Mr-Gollum/Identification-of-Dynamic-Properties-of-Thermocouples/Photos & videos/Construction complete.png

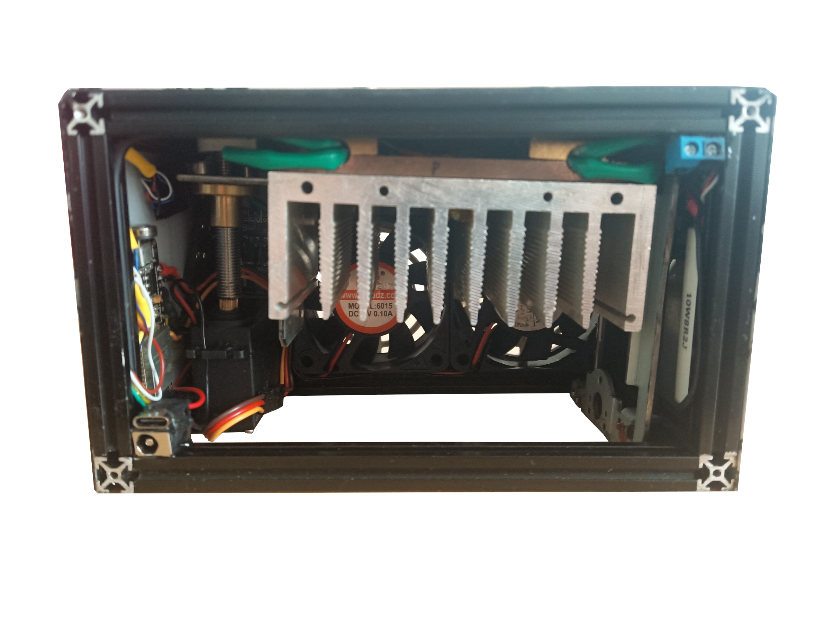
Photos & videos/Construction complete.png
