Mr-Gollum/Identification-of-Dynamic-Properties-of-Thermocouples/Photos & videos/Aluminum cooler linear slider.png

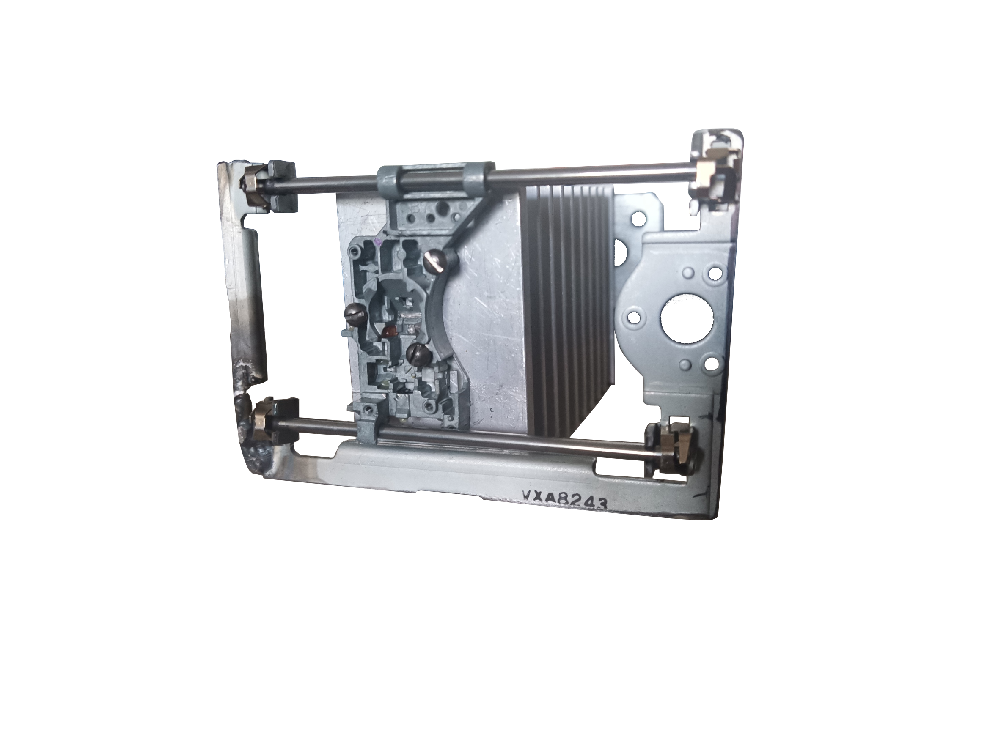
Photos & videos/Aluminum cooler linear slider.png
