Mr-Gollum/Identification-of-Dynamic-Properties-of-Thermocouples/Photos & videos/Copper cooler with additional blocks.png

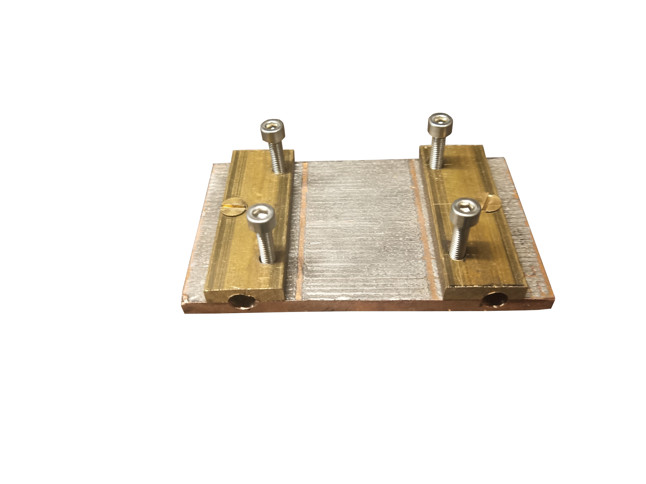
Photos & videos/Copper cooler with additional blocks.png
