Mr-Gollum/Identification-of-Dynamic-Properties-of-Thermocouples/Photos & videos/Copper cooler with DS18B20.png

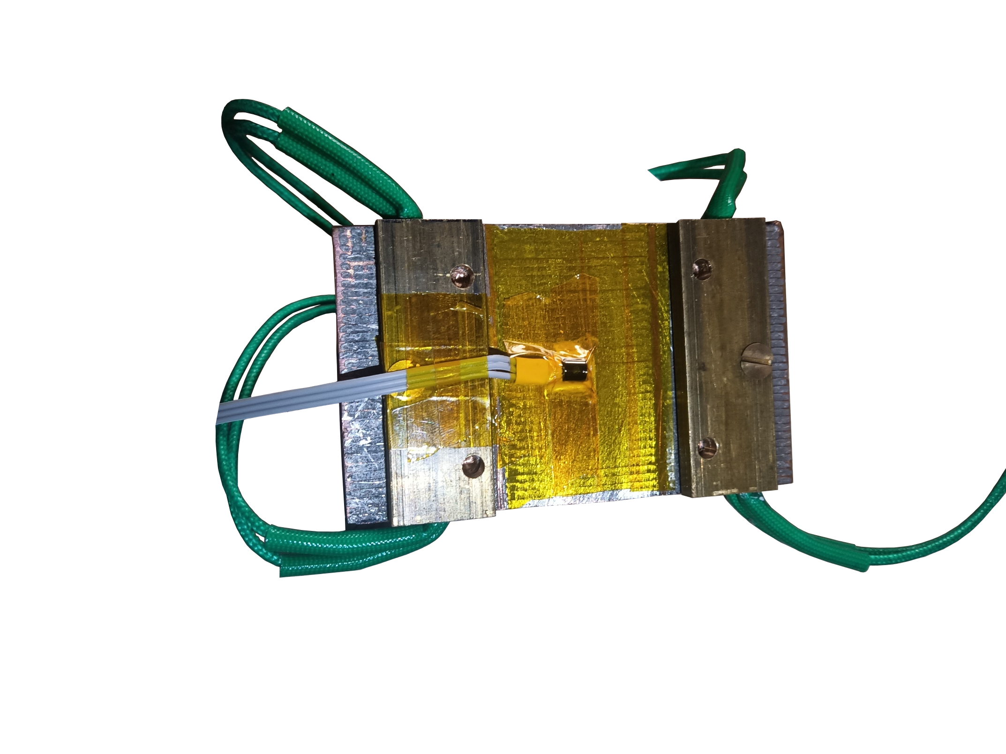
Photos & videos/Copper cooler with DS18B20.png
