Mr-Gollum/Identification-of-Dynamic-Properties-of-Thermocouples/Photos & videos/Frame with fans, heated block and mosfets.png

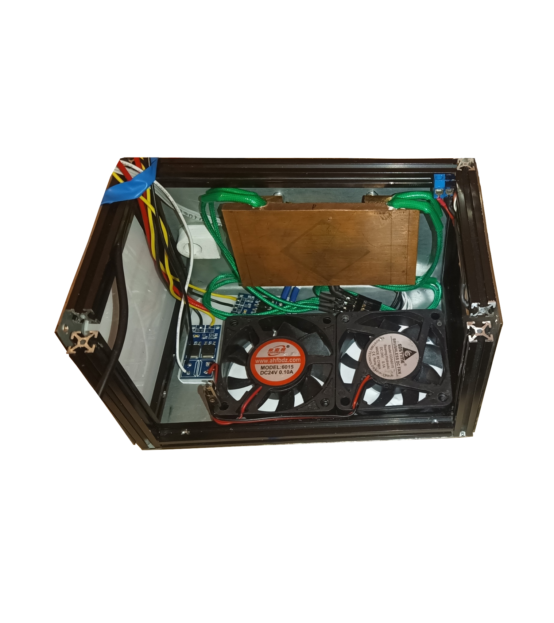
Photos & videos/Frame with fans, heated block and mosfets.png
