Mr-Gollum/Identification-of-Dynamic-Properties-of-Thermocouples/Photos & videos/Frame with heated block and aluminum cooler with linear slider.png

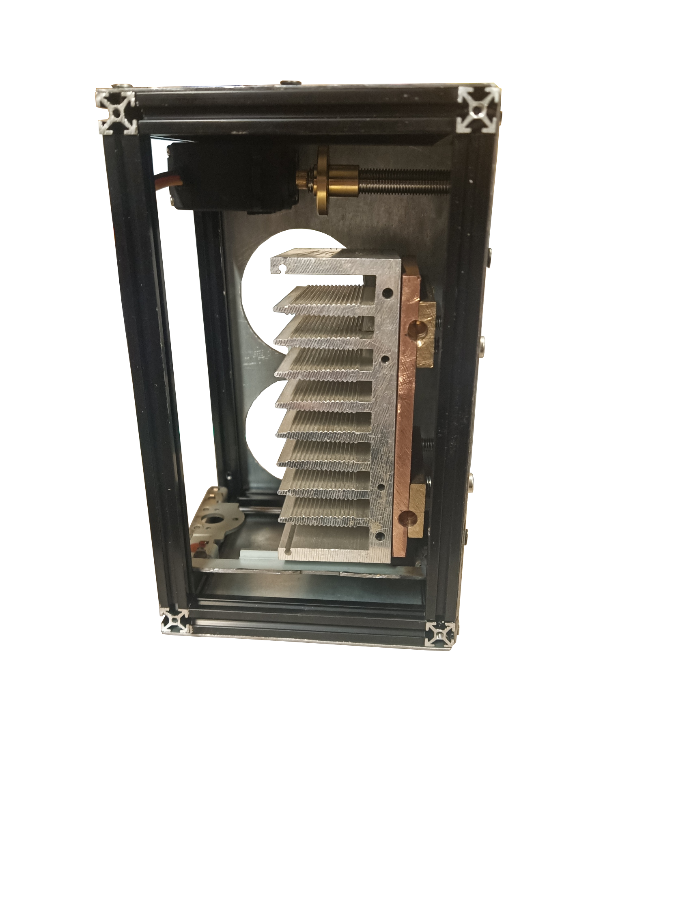
Photos & videos/Frame with heated block and aluminum cooler with linear slider.png
