Mr-Gollum/Identification-of-Dynamic-Properties-of-Thermocouples/Photos & videos/Frame.png

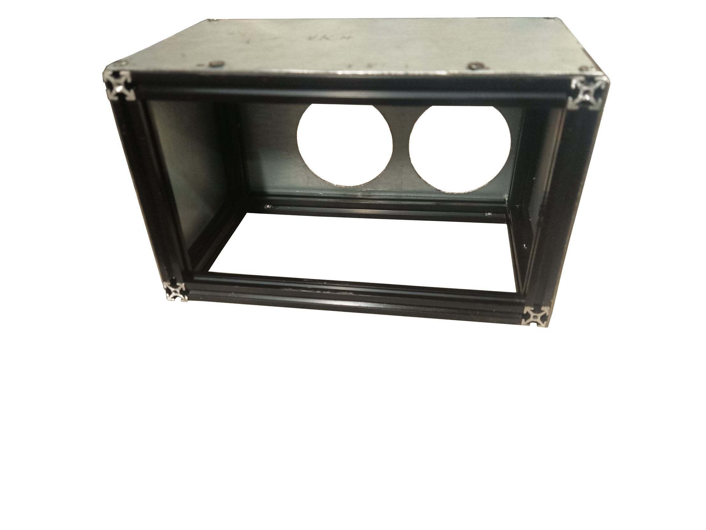
Photos & videos/Frame.png
