Mr-Gollum/Identification-of-Dynamic-Properties-of-Thermocouples/Measurement of SP1848/SP1848 1 Power.png

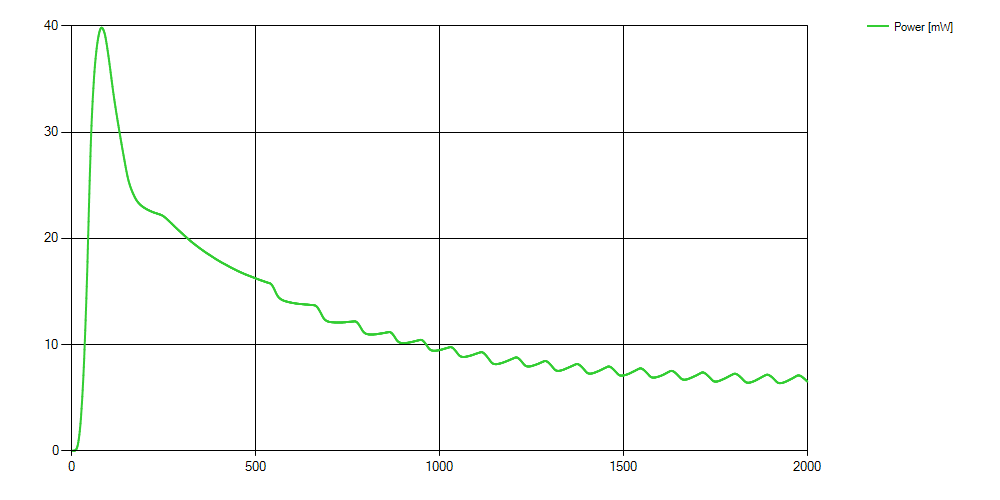
Measurement of SP1848/SP1848 1 Power.png
