Mr-Gollum/Identification-of-Dynamic-Properties-of-Thermocouples/Measurement of TEC12709/TEC12709 1 Temperature.png

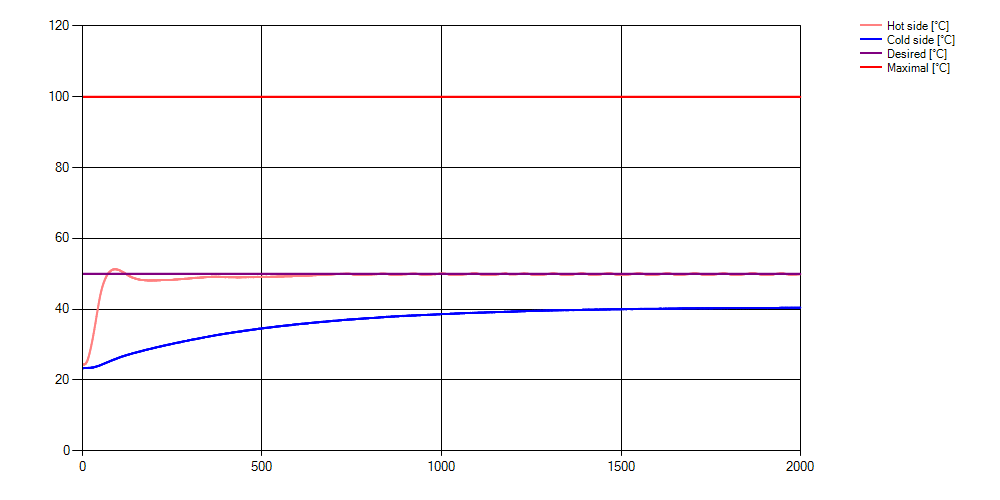
Measurement of TEC12709/TEC12709 1 Temperature.png
