Mr-Gollum/Identification-of-Dynamic-Properties-of-Thermocouples/Measurement of TEC12709/TEC12709 2 Power.png

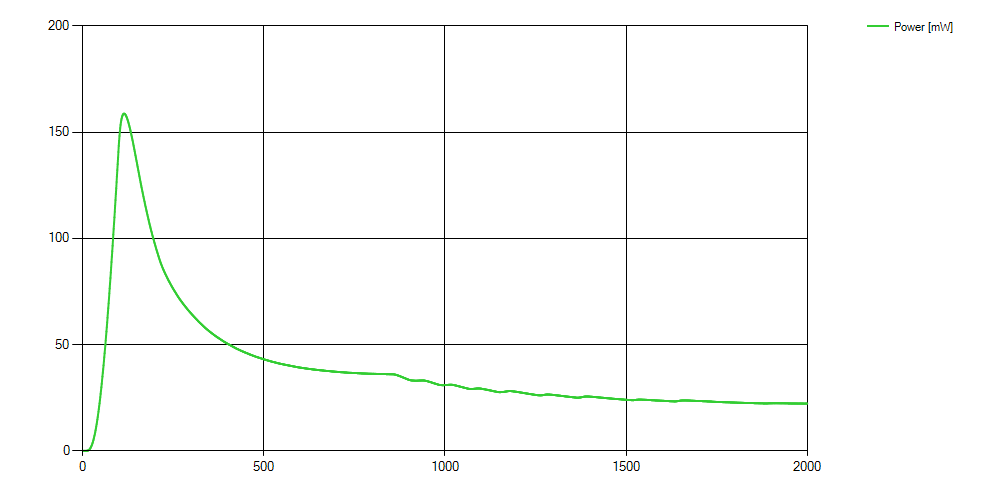
Measurement of TEC12709/TEC12709 2 Power.png
