Mr-Gollum/Identification-of-Dynamic-Properties-of-Thermocouples/Measurement of TEC12715/TEC12715 2 Power.png

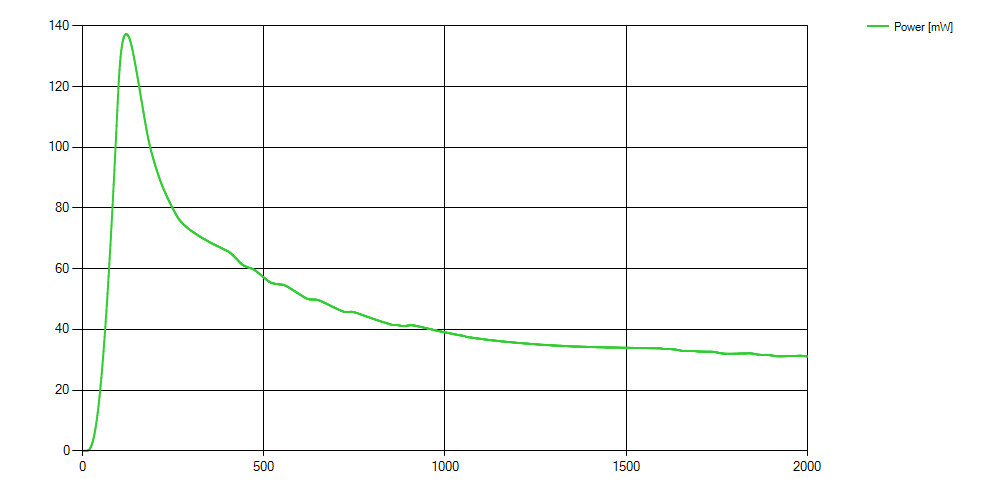
Measurement of TEC12715/TEC12715 2 Power.png
